ssnover/atmosensor/atmosensor-kicad/atmosensor-kicad.kicad_pcb

## KiCad design atmosensor-kicad/atmosensor-kicad.kicad_pcb (2022-11-11)

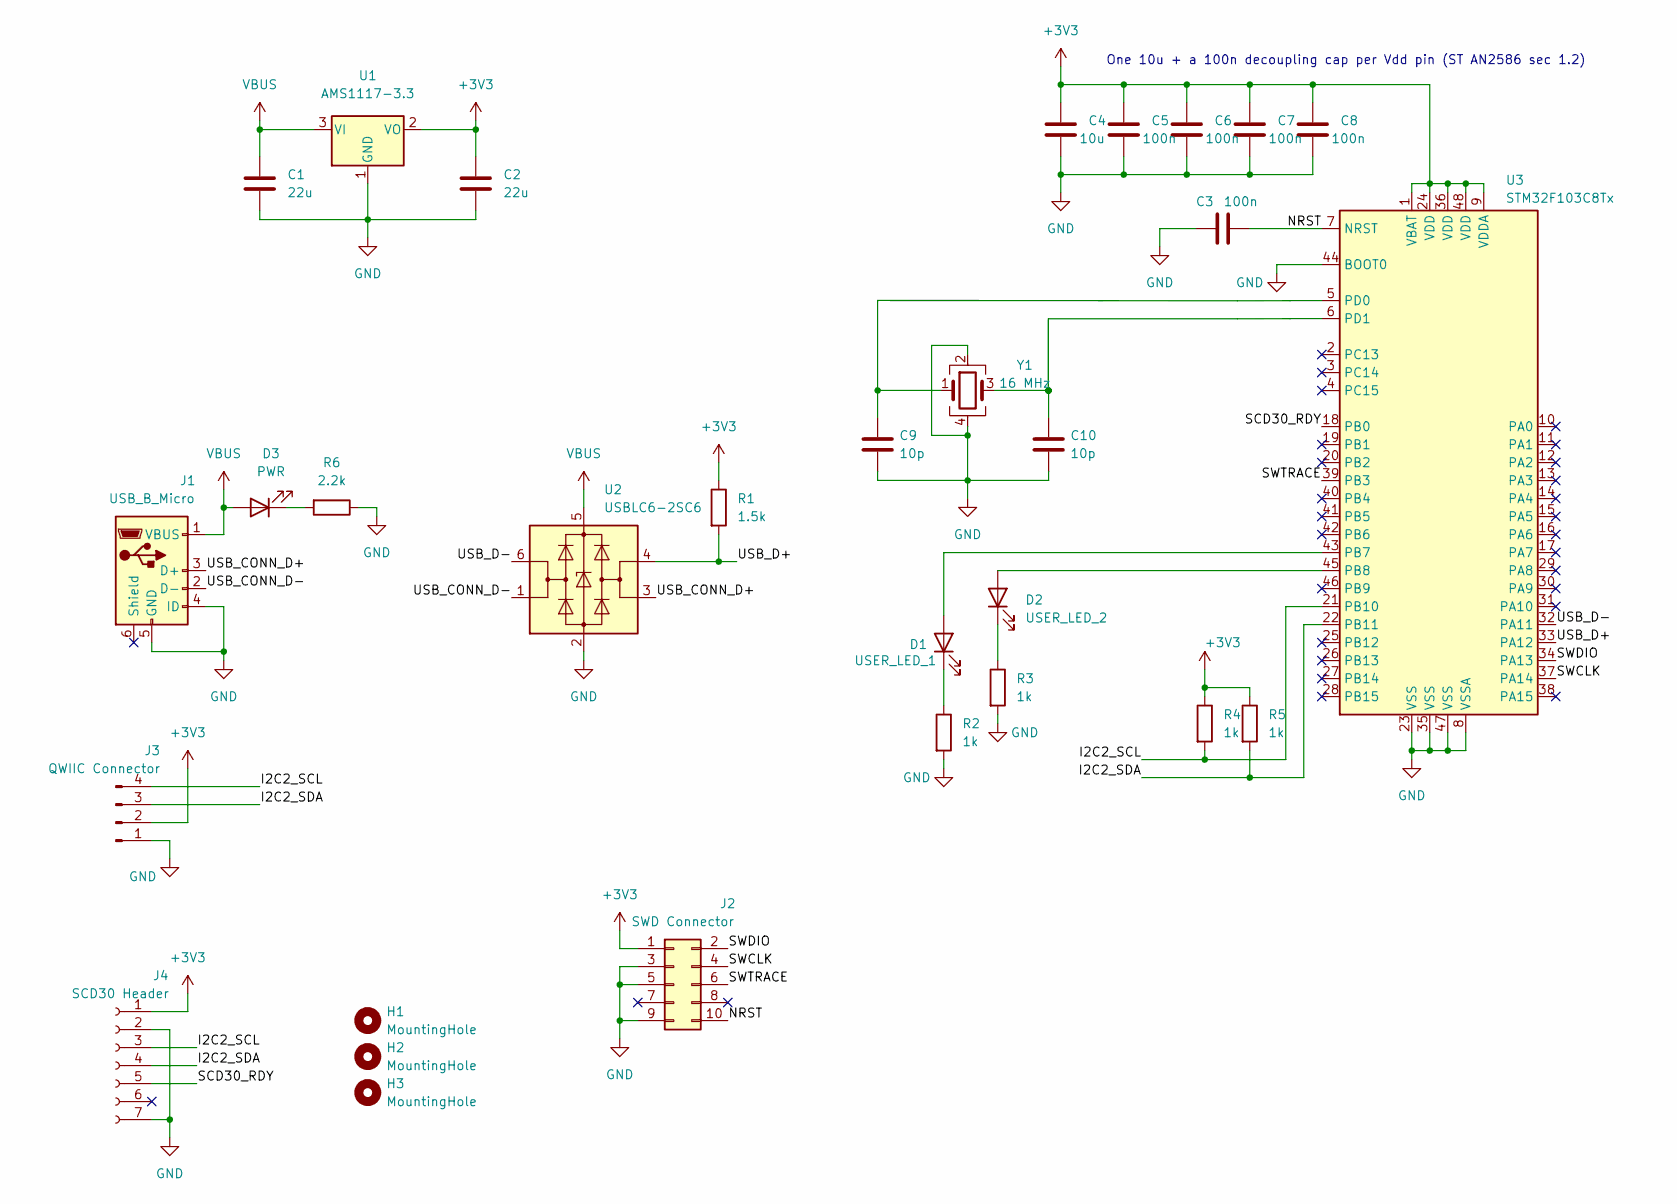
[picture p1: schematic atmosensor-kicad.kicad_sch]

Parts:
C1, C2: 22u; C_0603_1608Metric
C3, C5, C6, C7, C8: 100n; C_0402_1005Metric
C4: 10u; C_0603_1608Metric
C9, C10: 10p; C_0402_1005Metric
D1: USER_LED_1; LED_0402_1005Metric
D2: USER_LED_2; LED_0402_1005Metric
D3: PWR; LED_0402_1005Metric
H1, H2, H3: MountingHole; MountingHole_2.2mm_M2
J1: USB_B_Micro; USB_Micro-B_Amphenol_10103594-0001LF_Horizontal
J2: SWD Connector; PinHeader_2x05_P1.27mm_Vertical_SMD
J3: QWIIC Connector; JST_SM04B-SRSS-TB(LF)(SN)
J4: SCD30 Header; PinSocket_1x07_P2.54mm_Vertical
R1: 1.5k; R_0402_1005Metric
R2, R3, R4, R5: 1k; R_0402_1005Metric
R6: 2.2k; R_0402_1005Metric
U1: AMS1117-3.3; SOT-223-3_TabPin2
U2: USBLC6-2SC6; SOT-23-6
U3: STM32F103C8Tx; LQFP-48_7x7mm_P0.5mm
Y1: 16 MHz; Crystal_SMD_3225-4Pin_3.2x2.5mm

Connections:
+3V3: C2.1, C4.1, C5.1, C6.1, C7.1, C8.1, J2.1, J3.2, J4.1, R1.1, R4.1, R5.1, U1.2 (VO), U3.1 (VBAT), U3.9 (VDDA), U3.24 (VDD), U3.36 (VDD), U3.48 (VDD)
/I2C2_SCL: J3.4, J4.3, R4.2, U3.21 (PB10)
/I2C2_SDA: J3.3, J4.4, R5.2, U3.22 (PB11)
/NRST: C3.2, J2.10, U3.7 (NRST)
/SCD30_RDY: J4.5, U3.18 (PB0)
/SWCLK: J2.4, U3.37 (PA14)
/SWDIO: J2.2, U3.34 (PA13)
/SWTRACE: J2.6, U3.39 (PB3)
/USB_CONN_D+: J1.3 (D+), U2.3 (I/O2)
/USB_CONN_D-: J1.2 (D-), U2.1 (I/O1)
/USB_D+: R1.2, U2.4 (I/O2), U3.33 (PA12)
/USB_D-: U2.6 (I/O1), U3.32 (PA11)
GND: C1.2, C2.2, C3.1, C4.2, C5.2, C6.2, C7.2, C8.2, C9.2, C10.2, J1.4 (ID), J1.5 (GND), J2.3, J2.5, J2.9, J3.1, J4.2, J4.7, R2.2, R3.2, R6.1, U1.1 (GND), U2.2 (GND), U3.8 (VSSA), U3.23 (VSS), U3.35 (VSS), U3.44 (BOOT0), U3.47 (VSS), Y1.2, Y1.4
unnamed: C9.1, U3.5 (PD0), Y1.1
unnamed: C10.1, U3.6 (PD1), Y1.3
unnamed: D1.1 (K), R2.1
unnamed: D1.2 (A), U3.43 (PB7)
unnamed: D2.1 (K), R3.1
unnamed: D2.2 (A), U3.45 (PB8)
unnamed: D3.1 (K), R6.2
VBUS: C1.1, D3.2 (A), J1.1 (VBUS), U1.3 (VI), U2.5 (VBUS)

Notes on the sheet:
One 10u + a 100n decoupling cap per Vdd pin (ST AN2586 sec 1.2)

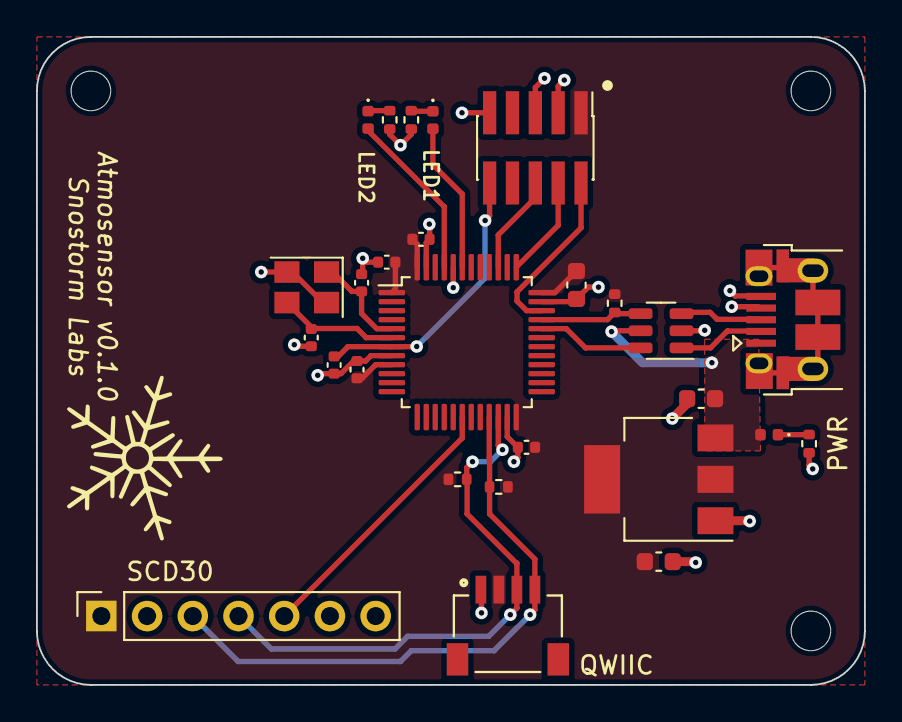
[picture p2: board atmosensor-kicad.kicad_pcb from above]

Board: 2 copper layers, 46.0 x 36.0 mm, 30 parts (0 on the bottom side), 21 nets.
