ssnover/atmosensor/atmosensor-kicad/atmosensor-kicad.ioc

Mcu.UserName=STM32F103C8Tx
PA11.Signal=USB_DM
PA12.Signal=USB_DP
PA13.Signal=SYS_JTMS-SWDIO
PA14.Signal=SYS_JTCK-SWCLK
PB0.Signal=GPXTI0
PB10.Signal=I2C2_SCL
PB11.Signal=I2C2_SDA
PB3.Signal=SYS_JTDO-TRACESWO
PB6.GPIO_Label=USER_LED_2
PB6.Signal=GPIO_Output
PB7.GPIO_Label=USER_LED_1
PB7.Signal=GPIO_Output
PD0-OSC_IN.Signal=RCC_OSC_IN
PD1-OSC_OUT.Signal=RCC_OSC_OUT
