ssnover/atmosensor/(commit log)

2022-11-11 MONOREPOgit add README.md !
    [atmosensor-kicad.kicad_pcb, atmosensor-kicad.kicad_sch]
2022-12-03 Moved all of the encoding and decoding out of the interrupt, but now things are not working...
    [cmd_receiver.rs, main.rs]
2023-01-07 Get a command queue building and an led module
2023-01-22 Managed to send a command to sensor based on usb message, but it failed so its logic analyzer time
    [cmd_queue.rs, led.rs, main.rs, sensor.rs, static_resources.rs, usb_handler.rs]
2023-01-25 Came up with way to not be leaking the actual type of my embedded hal objects
    [sensor.rs, static_resources.rs]
2023-01-29 Fix safety issue with access to command queue in the scd30 data ready interrupt
    [cmd_queue.rs, main.rs, sensor.rs, static_resources.rs, usb_handler.rs]
2023-05-20 Add commands to the firmware for querying humidity and temperature
2023-05-20 Start requesting and reporting humidity and temperature data
